untaugh/KeyBoard/pinout.png

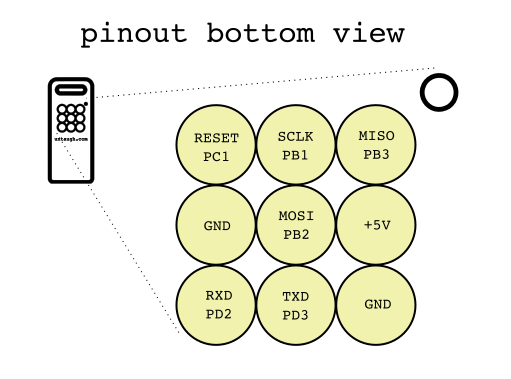
pinout.png
