untaugh/KeyBoard/pinout_bot.png

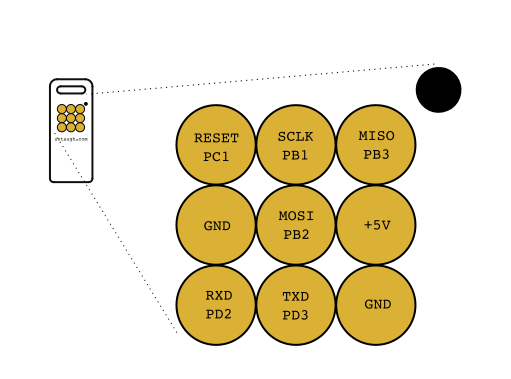
pinout_bot.png
