untaugh/KeyBoard/pinout_top.png

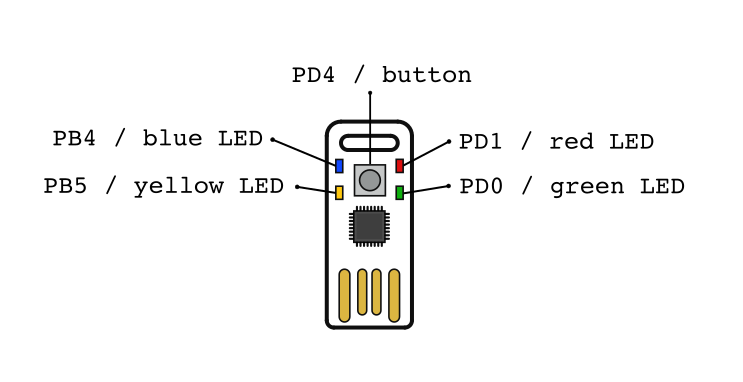
pinout_top.png
