untaugh/KeyBoard/pcb/keyboard2.kicad_pcb

## KiCad design pcb/keyboard2.kicad_pcb (2016-06-17)

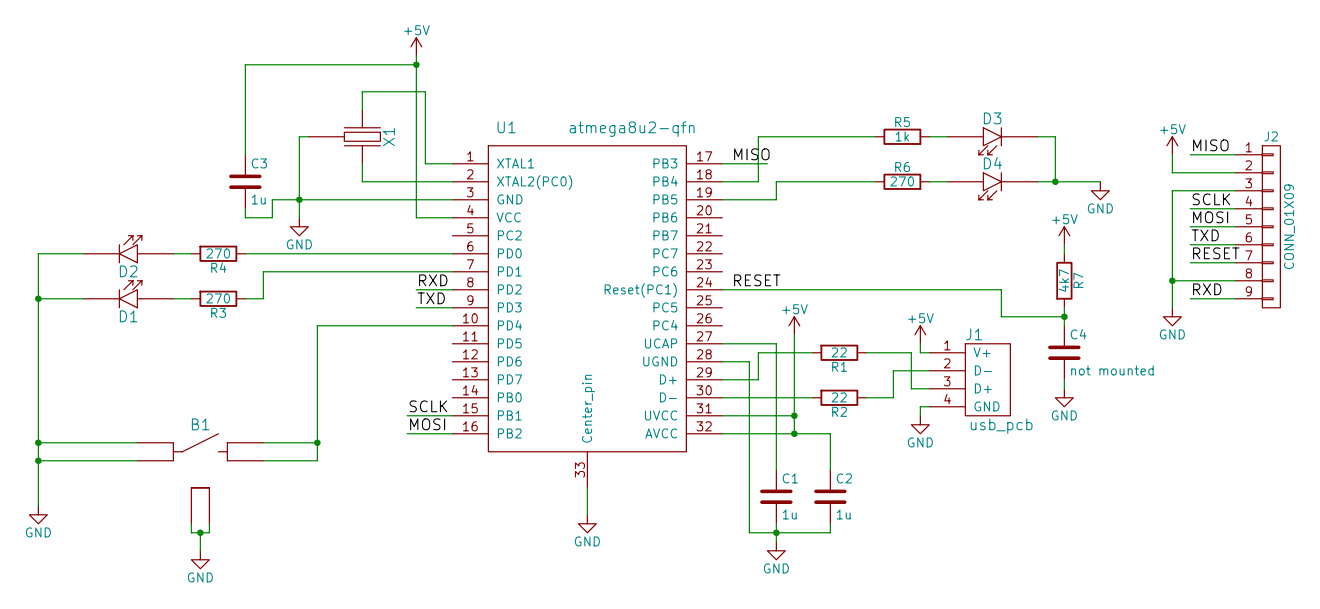
[picture p4: schematic keyboard2.sch]

Parts:
B1: btn_sp2; button_smd_panasonic; DigikeyPart P8045SCT-ND
C1, C2, C3: 1u; C_0402_nosilk; DigikeyPart 311-1702-1-ND
C4: not mounted; C_0402_nosilk; DigikeyPart 311-1335-1-ND
D1: led_red; LED_0603_nosilk; DigikeyPart 160-1446-1-ND
D2: led_green; LED_0603_nosilk; DigikeyPart 160-1447-1-ND
D3: led_blue; LED_0603_nosilk; DigikeyPart 160-1448-1-ND
D4: led_yellow; LED_0603_nosilk; DigikeyPart 160-1647-1-ND
J1: usb_pcb
J2: CONN_01X09; connector_smd_round2
R1, R2: 22; R_0402_nosilk; DigikeyPart 311-22.0LRCT-ND
R3, R4, R6: 270; R_0402_nosilk; DigikeyPart 311-270LRCT-ND
R5: 1k; R_0402_nosilk; DigikeyPart 311-1KLBCT-ND
R7: 4k7; R_0402_nosilk; DigikeyPart 311-4.7KLRCT-ND
U1: atmega8u2-qfn; qfn32_nosilk; DigikeyPart ATMEGA32U2-MURCT
X1: resonator; resonator_murata_smd; DigikeyPart 490-1219-1-ND

Connections:
+5V: C2.1, C3.1, J1.1 (V+), J2.2, R7.1, U1.4 (VCC), U1.31 (UVCC), U1.32 (AVCC)
/MISO: J2.1, U1.17 (PB3)
/MOSI: J2.5, U1.16 (PB2)
/RESET: C4.1, J2.7, R7.2, U1.24 (Reset(PC1))
/RXD: J2.9, U1.8 (PD2)
/SCLK: J2.4, U1.15 (PB1)
/TXD: J2.6, U1.9 (PD3)
GND: B1.1 (p1), B1.2 (p2), B1.5 (gnd), B1.6 (gnd), C1.2, C2.2, C3.2, C4.2, D1.2 (cathode), D2.2 (cathode), D3.2 (cathode), D4.2 (cathode), J1.4 (GND), J2.3, J2.8, U1.3 (GND), U1.28 (UGND), U1.33 (Center_pin), X1.2 (p2)
unnamed: B1.3 (p3), B1.4 (p4), U1.10 (PD4)
unnamed: C1.1, U1.27 (UCAP)
unnamed: D1.1 (anode), R3.2
unnamed: D2.1 (anode), R4.2
unnamed: D3.1 (anode), R5.2
unnamed: D4.1 (anode), R6.2
unnamed: J1.2 (D-), R2.1
unnamed: J1.3 (D+), R1.1
unnamed: R1.2, U1.29 (D+)
unnamed: R2.2, U1.30 (D-)
unnamed: R3.1, U1.7 (PD1)
unnamed: R4.1, U1.6 (PD0)
unnamed: R5.1, U1.18 (PB4)
unnamed: R6.1, U1.19 (PB5)
unnamed: U1.1 (XTAL1), X1.1 (p1)
unnamed: U1.2 (XTAL2(PC0)), X1.3 (p3)

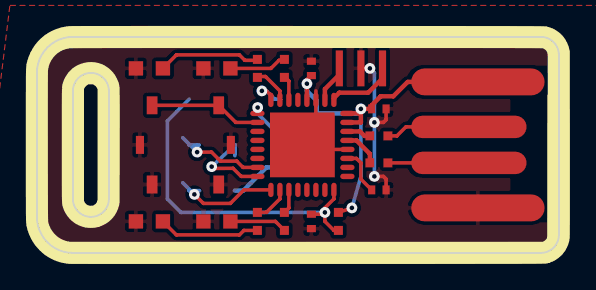
[picture p5: board keyboard2.kicad_pcb from above]

Board: 2 copper layers, 29.0 x 12.0 mm, 20 parts (1 on the bottom side), 24 nets.
