untaugh/KeyBoard/code/random.c

#include "random.h"

static volatile uint8_t * timer_p;

void random_init(volatile uint8_t * timer)
{
  timer_p = timer; 
}

uint8_t random_get(uint8_t limit)
{
  double random = (double)*timer_p/255;
  return random * limit;
}
