untaugh/KeyBoard/code/LUFAConfig.h

#ifndef LUFACONFIG_H
#define LUFACONFIG_H

#define USE_STATIC_OPTIONS (USB_DEVICE_OPT_FULLSPEED | USB_OPT_REG_ENABLED | USB_OPT_AUTO_PLL)

#define USB_DEVICE_ONLY
#define USE_FLASH_DESCRIPTORS
//#define USE_EEPROM_DESCRIPTORS
#define FIXED_CONTROL_ENDPOINT_SIZE      8
#define FIXED_NUM_CONFIGURATIONS         1

#endif // LUFACONFIG_H
