untaugh/KeyBoard/(commit log)

2015-10-13 First commit of the seconds version.
    [keyboard2-bom.csv, keyboard2.kicad_pcb, keyboard2.sch]
2015-10-19 Edit resistor value.
    [keyboard2-bom.csv, keyboard2.sch]
2015-10-24 Schematic part changes.
    [keyboard2-bom.csv, keyboard2.sch]
2015-11-07 Changed code for new pcb.
2015-11-07 A tool for holding stencil while applying paste.
    [stencilholder.scad]
2015-11-07 Updated stencilholder
    [stencilholder.scad]
2016-03-13 Fixed modulo bias in random generator.
    [random.c]
2016-06-17 added and updated libraries
    [keyboard2-bom.csv, keyboard2.kicad_pcb, keyboard2.sch]
2016-06-17 update reset capacitor not mounted
    [keyboard2.kicad_pcb, keyboard2.sch]
